auomoto/ATMega168_Nidec22H_BLDC_Motor/hardware/ATMega168_Nidec22H_BLDC_Motor_FullView.jpg

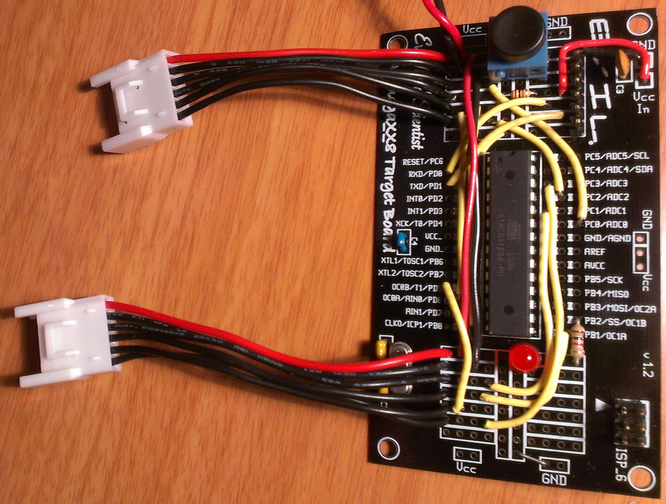
hardware/ATMega168_Nidec22H_BLDC_Motor_FullView.jpg
