auomoto/ATMega168_Nidec22H_BLDC_Motor/hardware/ATmega168_Nidec22H_BLDC_Motor.pdf

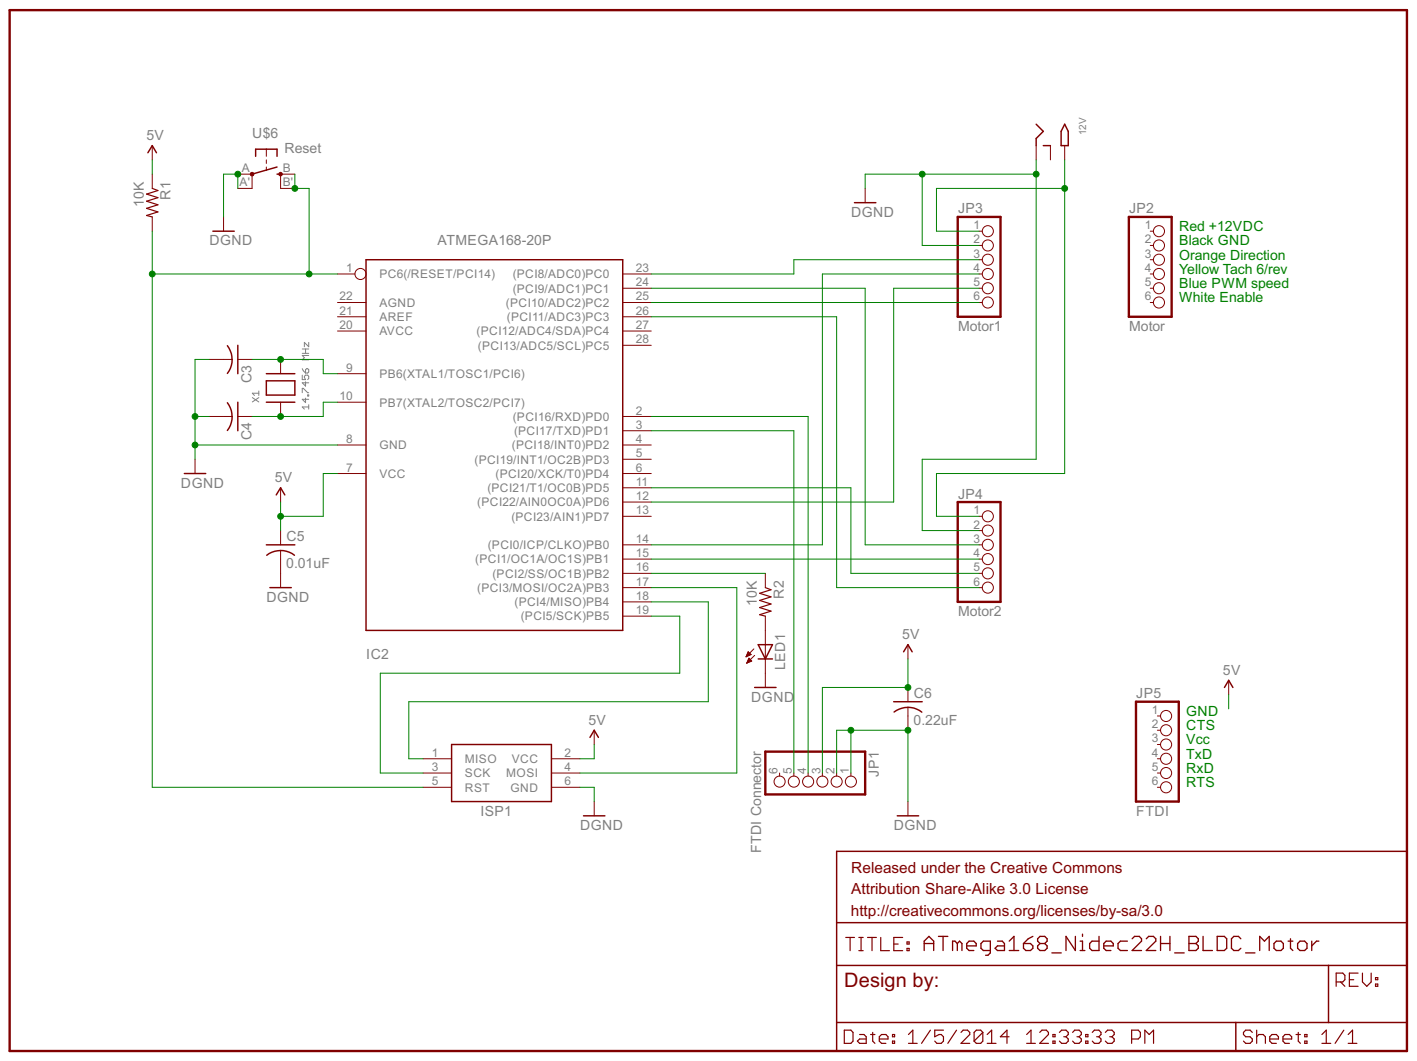
[picture p3: page 1]

Red +12VDC
Black GND
Orange Direction Yellow Tach 6/rev Blue PWM speed

6 Released under the Creative Commons Attribution Share-Alike 3.0 License

http://creativecommons.org/licenses/by-sa/3.0
