auomoto/ATMega168_Nidec22H_BLDC_Motor/hardware/ATmega168_Nidec22H_BLDC_Motor.sch

## EAGLE design hardware/ATmega168_Nidec22H_BLDC_Motor.sch (2014-01-05)

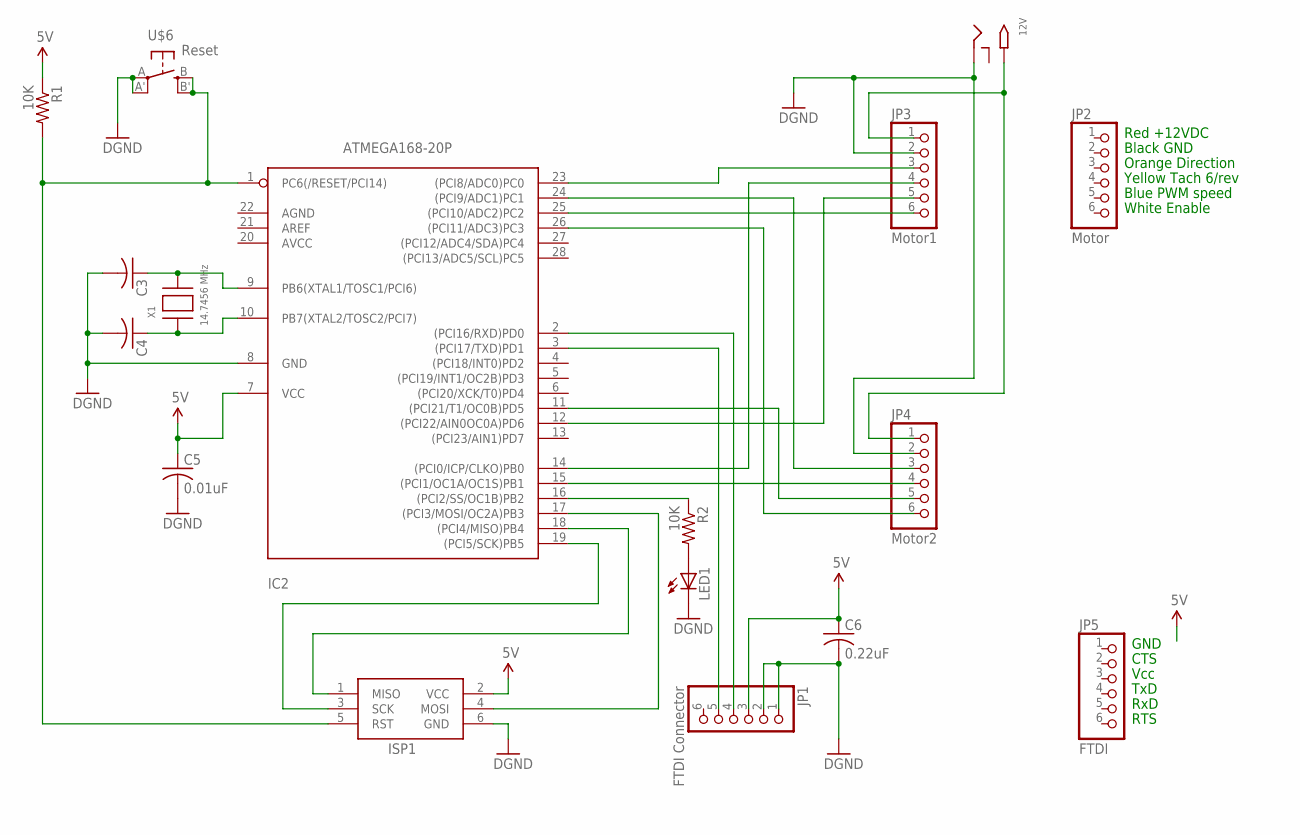
[picture p4: schematic ATmega168_Nidec22H_BLDC_Motor.sch]

Parts:
12V: 2.1MMJACKSMT; DCJACK_2MM_SMT
C3, C4: C-US025-024X044; C025-024X044
C5: 0.01uF; C025-024X044
C6: 0.22uF; C025-024X044
IC2: ATMEGA168-20P; DIL28-3
ISP1: AVRISP-6; AVRISP
JP1: FTDI Connector; 1X06
JP2: Motor; 1X06
JP3: Motor1; 1X06
JP4: Motor2; 1X06
JP5: FTDI; 1X06
LED1: LED5MM
R1, R2: 10K; V234/12
U$6: Reset; EVQ-Q2
X1: 14.7456 MHz; NX8045

Connections:
5V: C5.1, C6.1, IC2.7 (VCC), ISP1.2 (VCC), JP1.3, R1.1
24V: 12V.PWR2 (TIP), JP3.1, JP4.1
DIR-1: IC2.23 ((PCI8/ADC0)PC0), JP3.3
DIR-2: IC2.24 ((PCI9/ADC1)PC1), JP4.3
EN-1: IC2.25 ((PCI10/ADC2)PC2), JP3.6
EN-2: IC2.26 ((PCI11/ADC3)PC3), JP4.6
GND: 12V.GND (RING), C3.2, C4.2, C5.2, C6.2, IC2.8 (GND), ISP1.6 (GND), JP1.1, JP1.2, JP3.2, JP4.2, LED1.K (C), U$6.A, U$6.A' (P1)
MISO: IC2.18 ((PCI4/MISO)PB4), ISP1.1 (MISO)
MOSI: IC2.17 ((PCI3/MOSI/OC2A)PB3), ISP1.4 (MOSI)
unnamed: IC2.16 ((PCI2/SS/OC1B)PB2), R2.1
unnamed: C3.1, IC2.9 (PB6(XTAL1/TOSC1/PCI6)), X1.P$2
unnamed: C4.1, IC2.10 (PB7(XTAL2/TOSC2/PCI7)), X1.P$1
unnamed: LED1.A, R2.2
PWM-1: IC2.12 ((PCI22/AIN0OC0A)PD6), JP3.5
PWM-2: IC2.11 ((PCI21/T1/OC0B)PD5), JP4.5
RST: IC2.1 (PC6(/RESET/PCI14)), ISP1.5 (RST), R1.2, U$6.B (S), U$6.B' (S1)
RXD: IC2.3 ((PCI17/TXD)PD1), JP1.5
SCK: IC2.19 ((PCI5/SCK)PB5), ISP1.3 (SCK)
TACH-1: IC2.14 ((PCI0/ICP/CLKO)PB0), JP3.4
TACH-2: IC2.15 ((PCI1/OC1A/OC1S)PB1), JP4.4
TXD: IC2.2 ((PCI16/RXD)PD0), JP1.4

Notes on the sheet:
Red +12VDC
Black GND
Orange Direction
Yellow Tach 6/rev
Blue PWM speed
White Enable
GND
CTS
Vcc
TxD
RxD
RTS
