auomoto/ATMega168_Nidec22H_BLDC_Motor/(commit log)

2013-12-26 Updated comments motor type, Niden 12V Type 2
2013-12-26 Now working for two independent motors.
2014-01-05 Initial commit.
    [ATmega168_Nidec22H_BLDC_Motor.sch]
2014-01-05 Labeled nets
    [ATmega168_Nidec22H_BLDC_Motor.sch]
2014-01-05 Board photos added.
2014-01-05 Added motor description document.
2014-01-05 Updated motor type to Nidec 24volt Type 4.
2014-01-12 We might want to use motor with a full controller?
